rohanbaichwal1-rgb/Sutra/docs/pdfs/Sutra_Hardware_Schematic.pdf

# Sutra Hardware Schematic

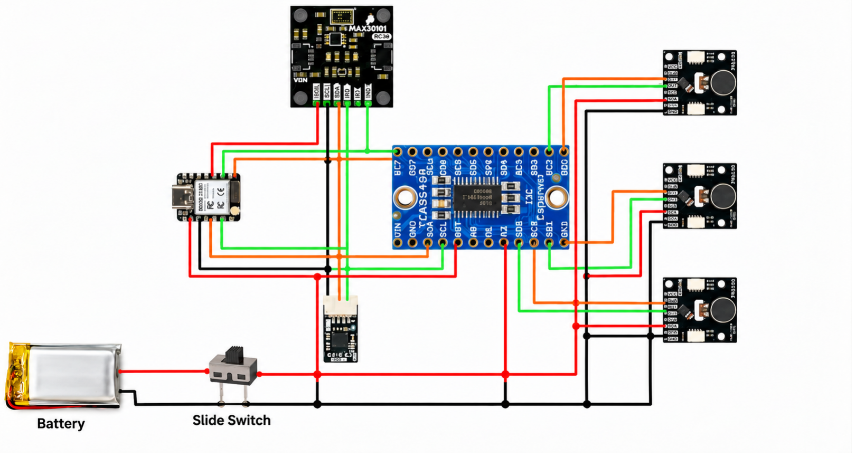
[picture p1: figure]

## Components shown

1. Seeed XIAO ESP32-S3 microcontroller
2. MAX30101 optical pulse sensor
3. BMI270 IMU module (small lower board, assumed)
4. TCA9548A I2C multiplexer
5. Three DA7280 haptic driver / motor modules
6. Lithium-polymer battery and slide ON/OFF switch

Illustration is conceptual: some printed pin labels and power connections may not be accurate.

Sutra | Simple hardware documentation | 1

# Simplified Electrical Connections

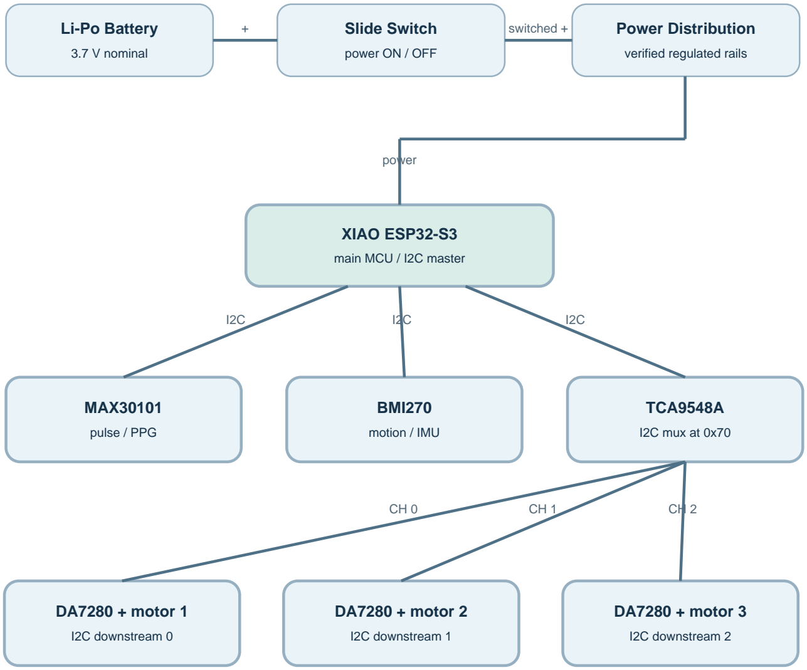
[picture p2: figure]
Li-Po Battery; 3.7 V nominal; Slide Switch; power ON / OFF; Power Distribution; verified regulated rails; switched +; XIAO ESP32-S3; main MCU / I2C master; power; MAX30101; pulse / PPG; BMI270; motion / IMU; TCA9548A; I2C mux at 0x70; DA7280 + motor 1; I2C downstream 0; DA7280 + motor 2; I2C downstream 1; DA7280 + motor 3; I2C downstream 2

## Basic wiring summary

Power: Battery (+) -> slide switch -> suitable regulated power rails; battery (-) -> common GND.

Communication: MCU SDA / SCL connect to MAX30101, BMI270 and TCA9548A input bus.

Haptics: TCA9548A channels 0, 1 and 2 connect to the three DA7280 modules.

Motor outputs are driven by the respective DA7280 boards, not MCU GPIO pins.

Before wiring hardware
Confirm each board voltage range and I2C pull-ups. A raw Li-Po cell is 4.2 V when fully charged. Use appropriate battery protection/charging and regulation; verify switch current rating and pinout.
Sutra | Simple hardware documentation | 2
