rohanbaichwal1-rgb/Sutra/docs/pdfs/P1_Followup_Pattern_Flowchart_4.pdf

## SUTRA | P1 and Follow-up Haptics

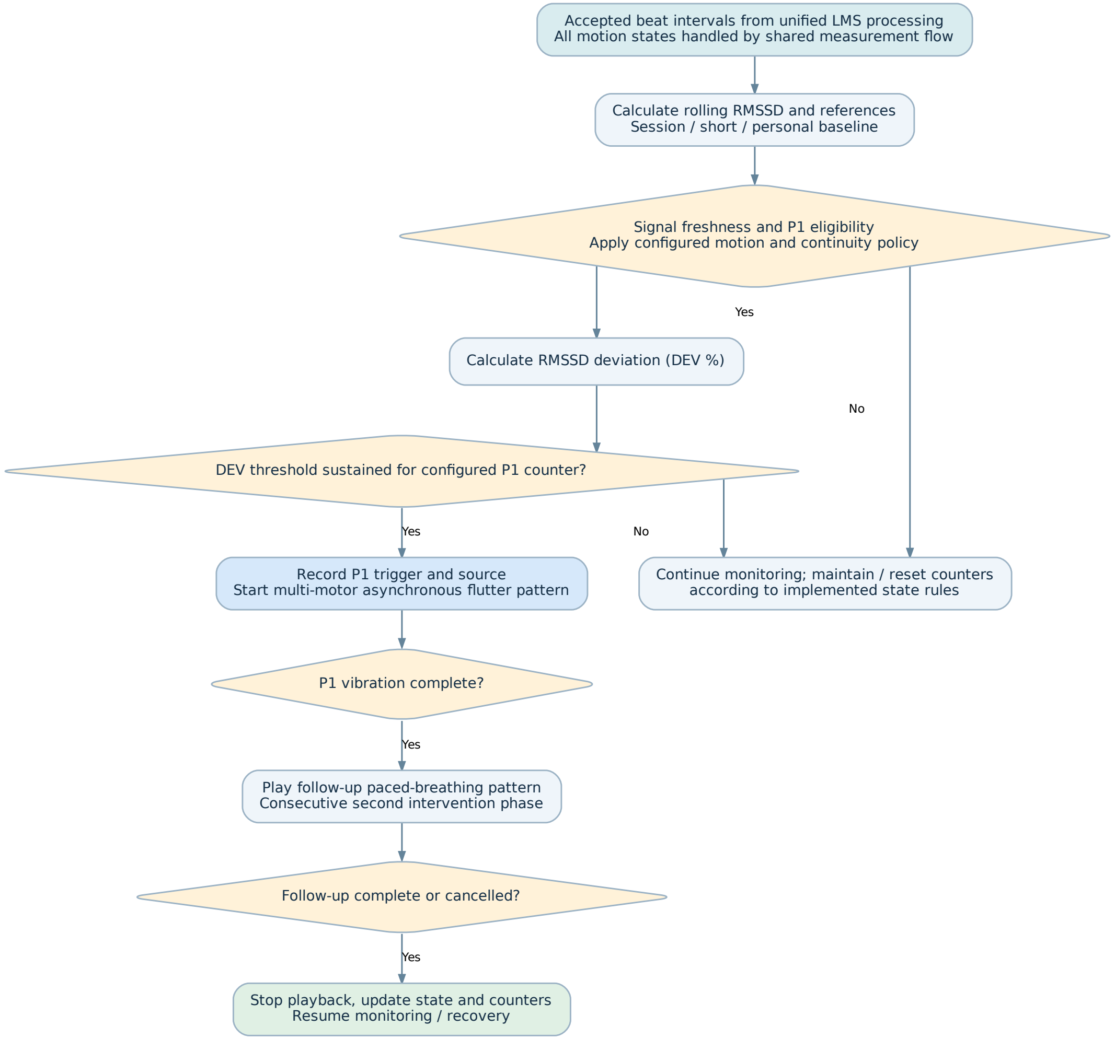
[picture p3: figure]
Yes; Calculate rolling RMSSD and references Session / short / personal baseline; Signal freshness and P1 eligibility; Calculate RMSSD deviation (DEV %); according to implemented state rules; Record P1 trigger and source Start multi-motor asynchronous flutter pattern; P1 vibration complete?; Play follow-up paced-breathing pattern Consecutive second intervention phase; Follow-up complete or cancelled?; Resume monitoring / recovery

Accepted beat intervals from unified LMS processing All motion states handled by shared measurement flow

Apply configured motion and continuity policy

DEV threshold sustained for configured P1 counter?

Continue monitoring; maintain / reset counters

Stop playback, update state and counters
