rohanbaichwal1-rgb/Sutra/docs/pdfs/PDR_Flowchart_5.pdf

## SUTRA | PDR Respiratory Rate

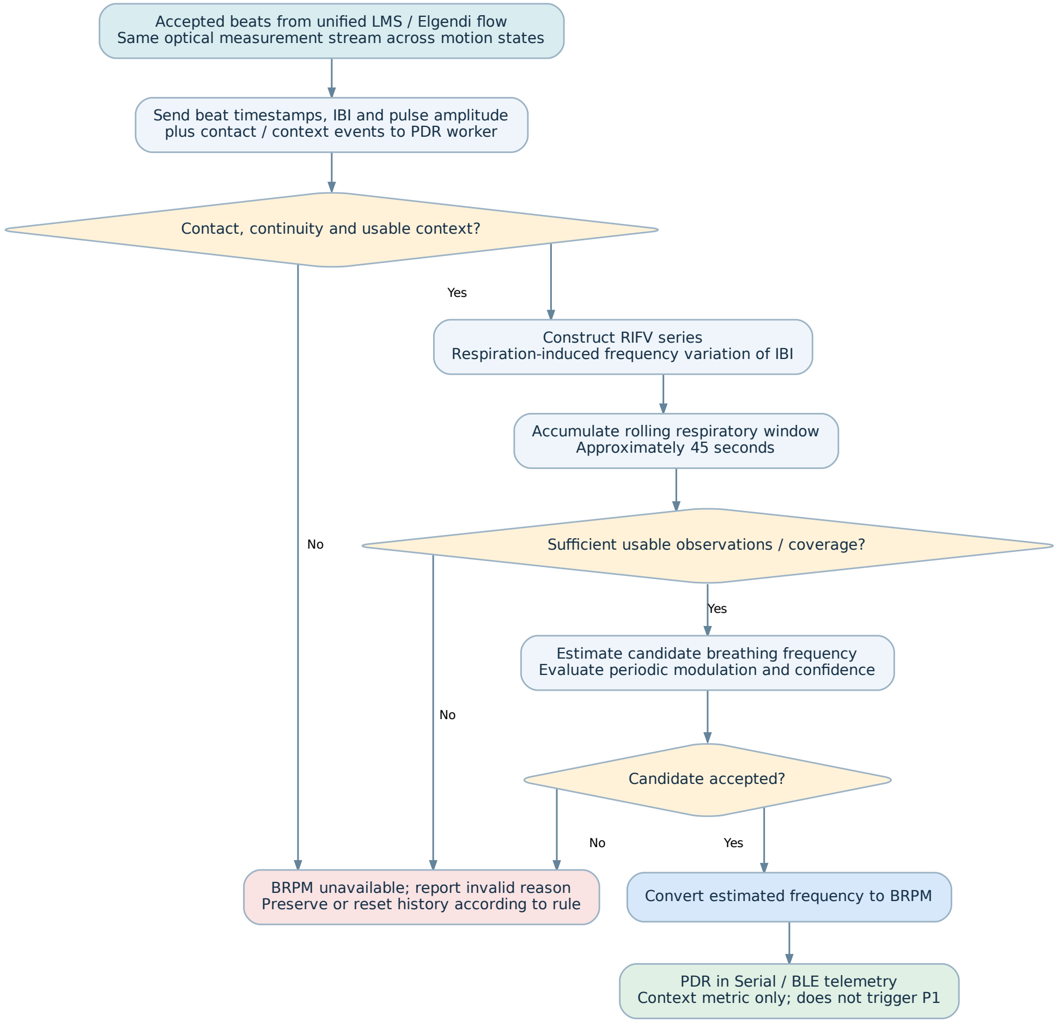
[picture p4: figure]
Yes; Contact, continuity and usable context?; BRPM unavailable; report invalid reason; Construct RIFV series Respiration-induced frequency variation of IBI; Accumulate rolling respiratory window Approximately 45 seconds; Sufficient usable observations / coverage?; Estimate candidate breathing frequency Evaluate periodic modulation and confidence; Candidate accepted?; Convert estimated frequency to BRPM; PDR in Serial / BLE telemetry

Accepted beats from unified LMS / Elgendi flow Same optical measurement stream across motion states

Send beat timestamps, IBI and pulse amplitude plus contact / context events to PDR worker

Preserve or reset history according to rule

Context metric only; does not trigger P1
