rohanbaichwal1-rgb/Sutra/docs/mechanical/SPOC 2 (1).STEP

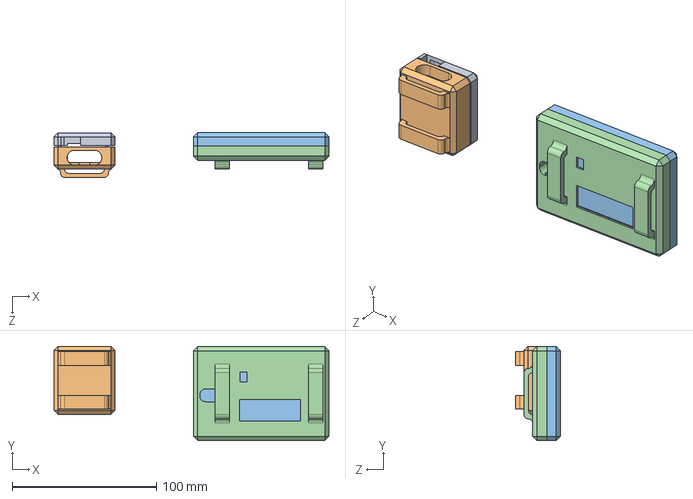
[picture p5: CAD file, 2026-10-19]
docs/mechanical/SPOC 2 (1).STEP
190.9 x 65.5 x 31.2 mm
