rohanbaichwal1-rgb/Sutra/docs/pdfs/Elgendi_Algorithm_Flowchart_2.pdf

## SUTRA | Elgendi Pulse Detection

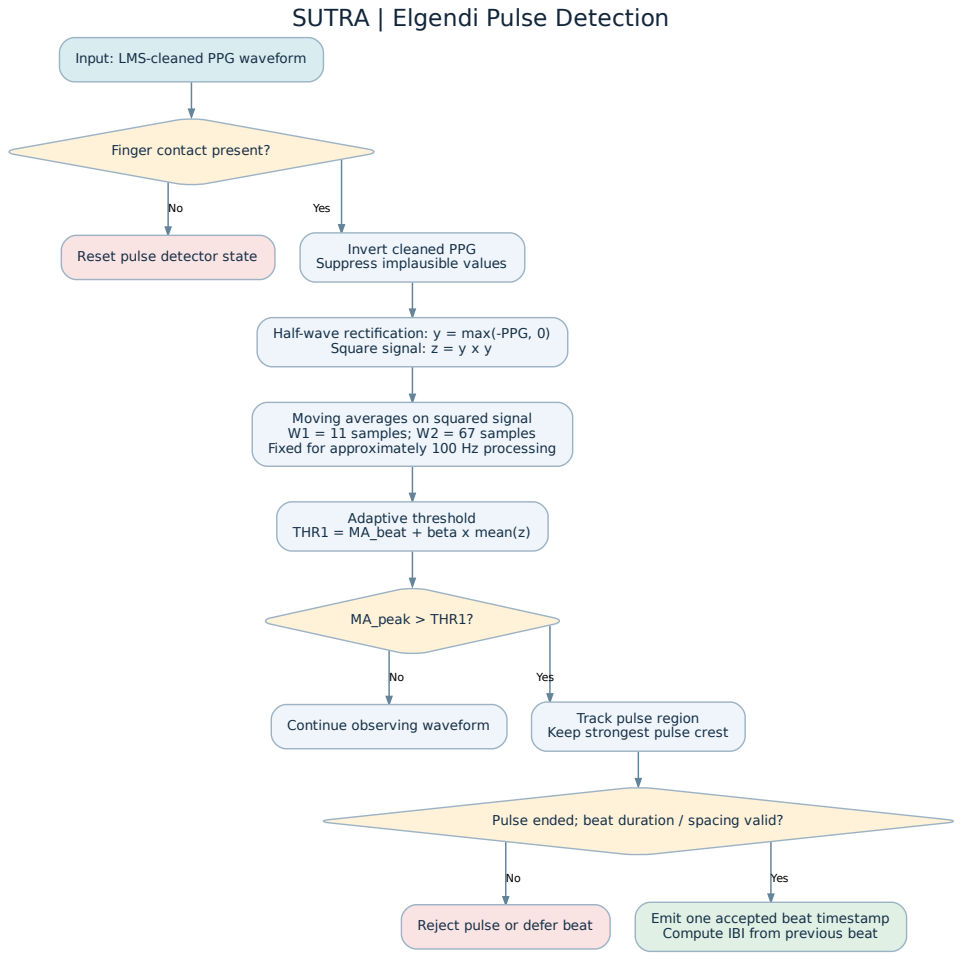
[picture p6: page 1]
Yes; Reset pulse detector state; Invert cleaned PPG; Square signal: z = y x y; Adaptive threshold THR1 = MA_beat + beta x mean(z); MA_peak > THR1?; Continue observing waveform; Track pulse region; Reject pulse or defer beat; Emit one accepted beat timestamp

Input: LMS-cleaned PPG waveform

Finger contact present?

Suppress implausible values

Half-wave rectification: y = max(-PPG, 0)

Moving averages on squared signal
W1 = 11 samples; W2 = 67 samples
Fixed for approximately 100 Hz processing

Keep strongest pulse crest

Pulse ended; beat duration / spacing valid?

Compute IBI from previous beat
