rohanbaichwal1-rgb/Sutra/docs/pdfs/LMS_HR_IBI_Flowchart_3.pdf

## SUTRA | LMS HR and IBI

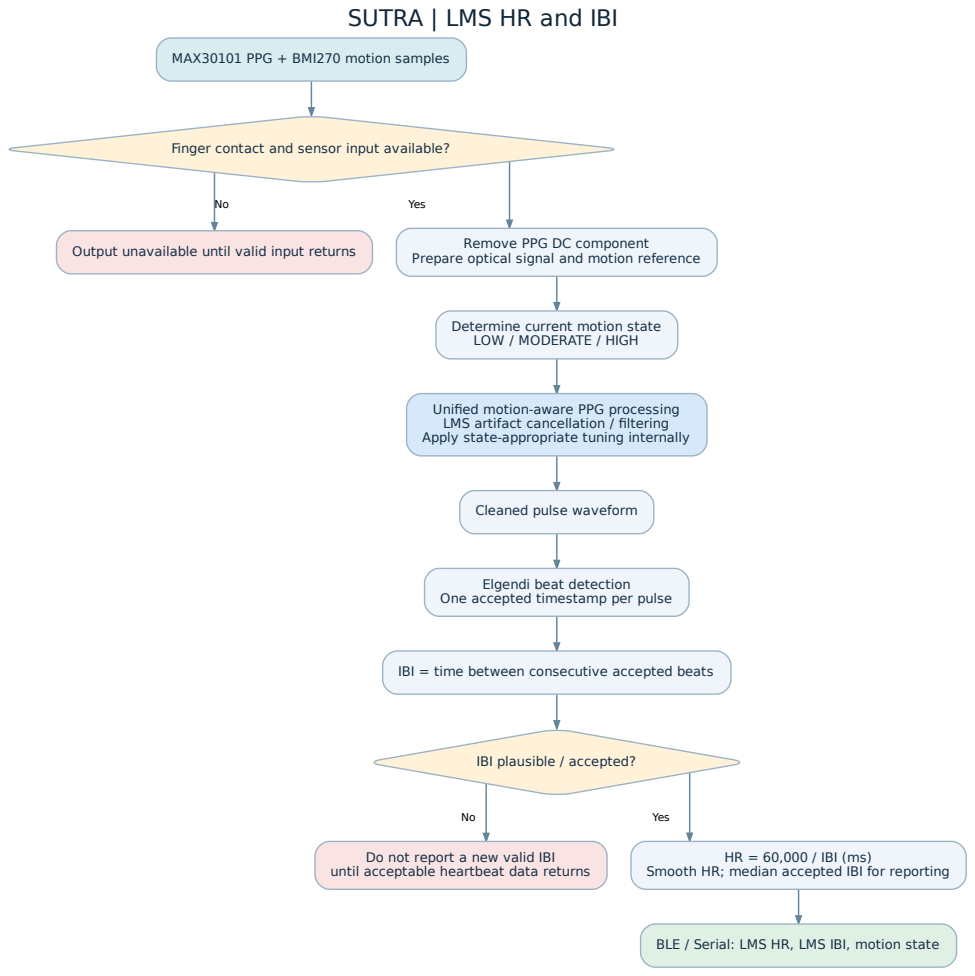
[picture p7: page 1]
Yes; Output unavailable until valid input returns; Remove PPG DC component

MAX30101 PPG + BMI270 motion samples

Finger contact and sensor input available?

Prepare optical signal and motion reference

Determine current motion state
LOW / MODERATE / HIGH

Unified motion-aware PPG processing
LMS artifact cancellation / filtering
Apply state-appropriate tuning internally

Cleaned pulse waveform

Elgendi beat detection
One accepted timestamp per pulse

IBI = time between consecutive accepted beats

IBI plausible / accepted?

Do not report a new valid IBI
until acceptable heartbeat data returns

HR = 60,000 / IBI (ms)

Smooth HR; median accepted IBI for reporting

BLE / Serial: LMS HR, LMS IBI, motion state
