rohanbaichwal1-rgb/Sutra/docs/pdfs/Sutra_Overall_Project_Flowchart_1.pdf

## SUTRA | Overall Project Flow

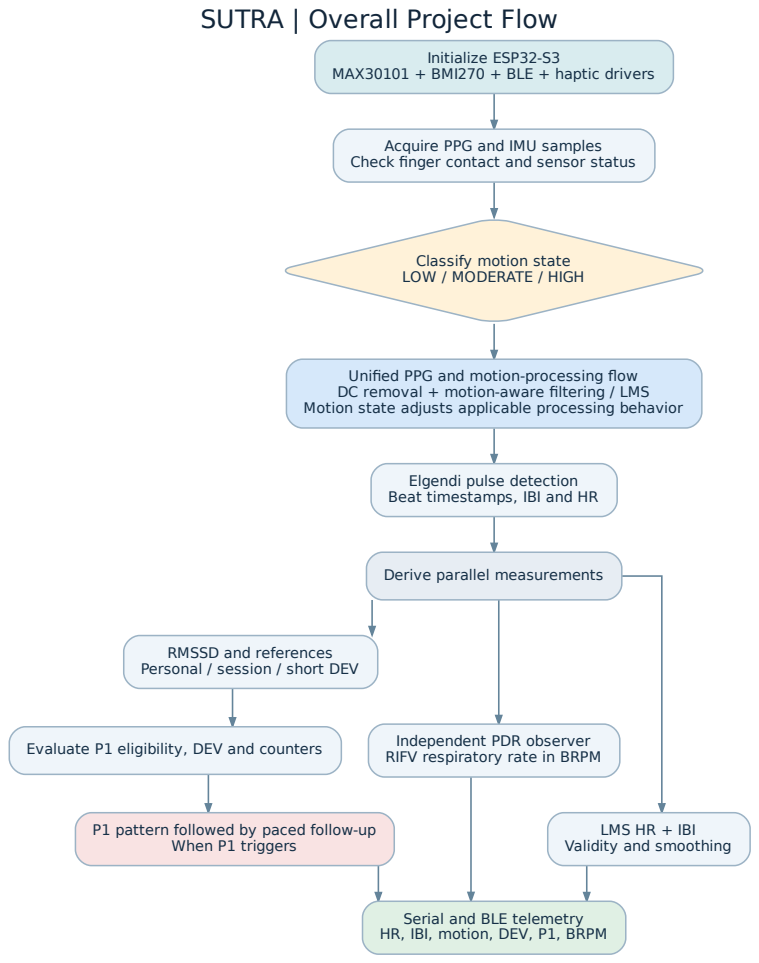
[picture p8: page 1]
Initialize ESP32-S3; When P1 triggers

MAX30101 + BMI270 + BLE + haptic drivers

Acquire PPG and IMU samples
Check finger contact and sensor status

Classify motion state
LOW / MODERATE / HIGH

Unified PPG and motion-processing flow
DC removal + motion-aware filtering / LMS
Motion state adjusts applicable processing behavior

Elgendi pulse detection
Beat timestamps, IBI and HR

Derive parallel measurements

RMSSD and references
Personal / session / short DEV

Independent PDR observer
RIFV respiratory rate in BRPM

Evaluate P1 eligibility, DEV and counters

P1 pattern followed by paced follow-up

LMS HR + IBI
Validity and smoothing

Serial and BLE telemetry
HR, IBI, motion, DEV, P1, BRPM
