rohanbaichwal1-rgb/Sutra/src/PdrService.h

#pragma once
#include <PdrObserver.h>

namespace pdrService {
bool begin();
void beat(uint32_t time, float amplitude, float ibi);
void contactChanged(uint32_t now);
void context(uint32_t now, const pdr::Context &context);
pdr::Result read(uint32_t now);
}
