rohanbaichwal1-rgb/Sutra/(commit log)

2026-09-21 Implement short, session baseline and postexercise
    [NvsBaselineStore.h, main.cpp, test_main.cpp]
2026-09-23 The given code is for a single motor
2026-09-24 Code Implemented for 3 motors
2026-10-19 Updated the docs to include links of BOM, Logs and results
